afk0901/ROBOTIX/README.md

# ROBOTIX
Merkmið verkefnisins er að búa til vél sem blandar drykki eða eitthvað annað, svona einhversskonar blandara í glas eða annað ílát. Verkefnið felst í því að nota Arduino til að stjórna hvernig blandað er og hvenær.
Við völdum þetta verkefni því að okkur fannst það vera flott og skemmtilegt verkefni. Við fórum á google og leituðum af arduino verkefnum, þetta verkefni leit vel út og er nokkuð stórt og krefjandi. Við einfölduðum þetta smávegis því að sá sem bjó til verkefnið sem við vorum að skoða var með fleiri flöskur. Verkefnið gengur út á það að búa til bar með flöskum og segullokum til þess að blanda kokteila eða aðra góða drykki. Það væri líka hægt að nota þetta til að blanda málningu. Þetta er þá einhversskonar blandari. Hægt verður að setja vatn í flöskur og vatnið rennur niður þegar segullokarnir opnast. Hægt er að velja um nokkrar mismunandi blöndur. Við nýtum okkur þyngdarlögmálið til að fá vatnið til þess að leka niður í segullokann.
